Halcik/SmartPlant_Dashboard/schematy_blokowe.pdf

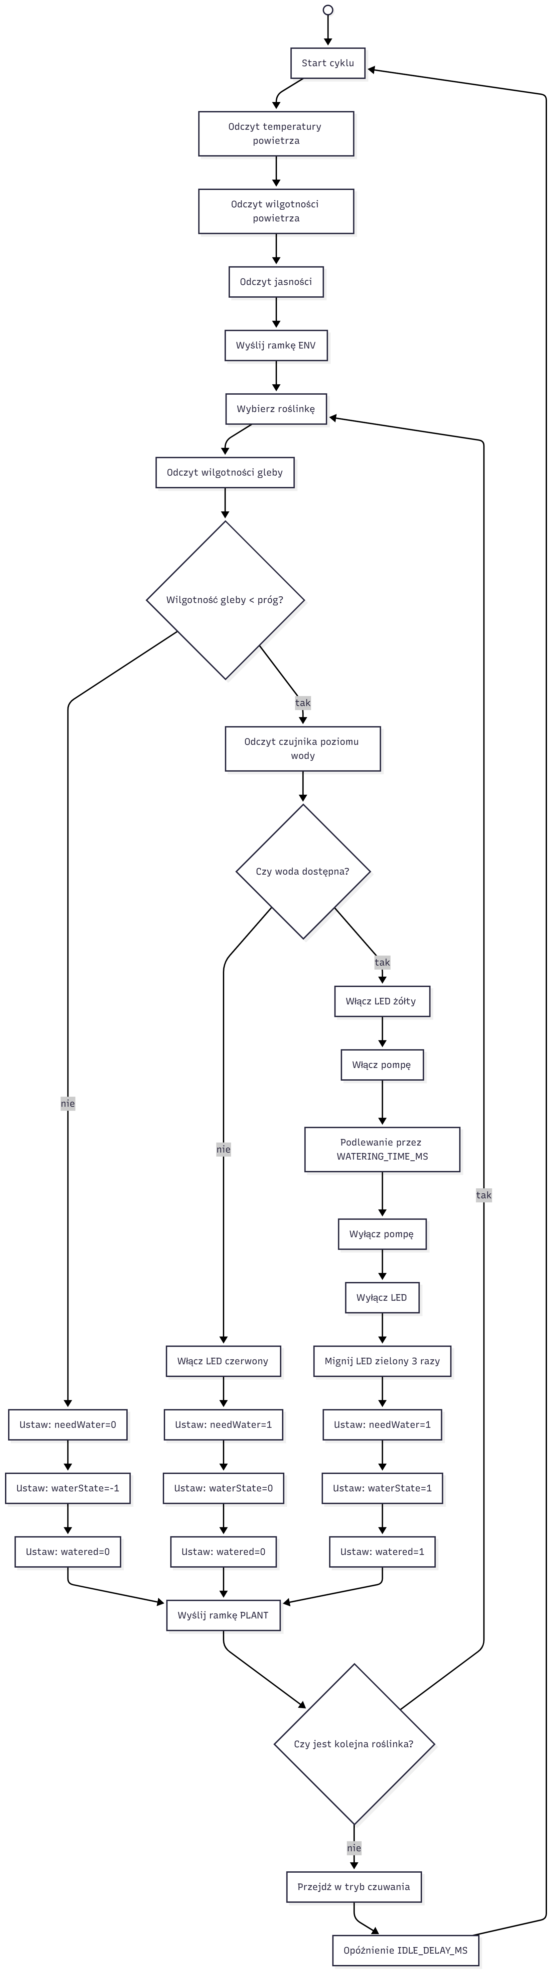
[picture p9: page 1]
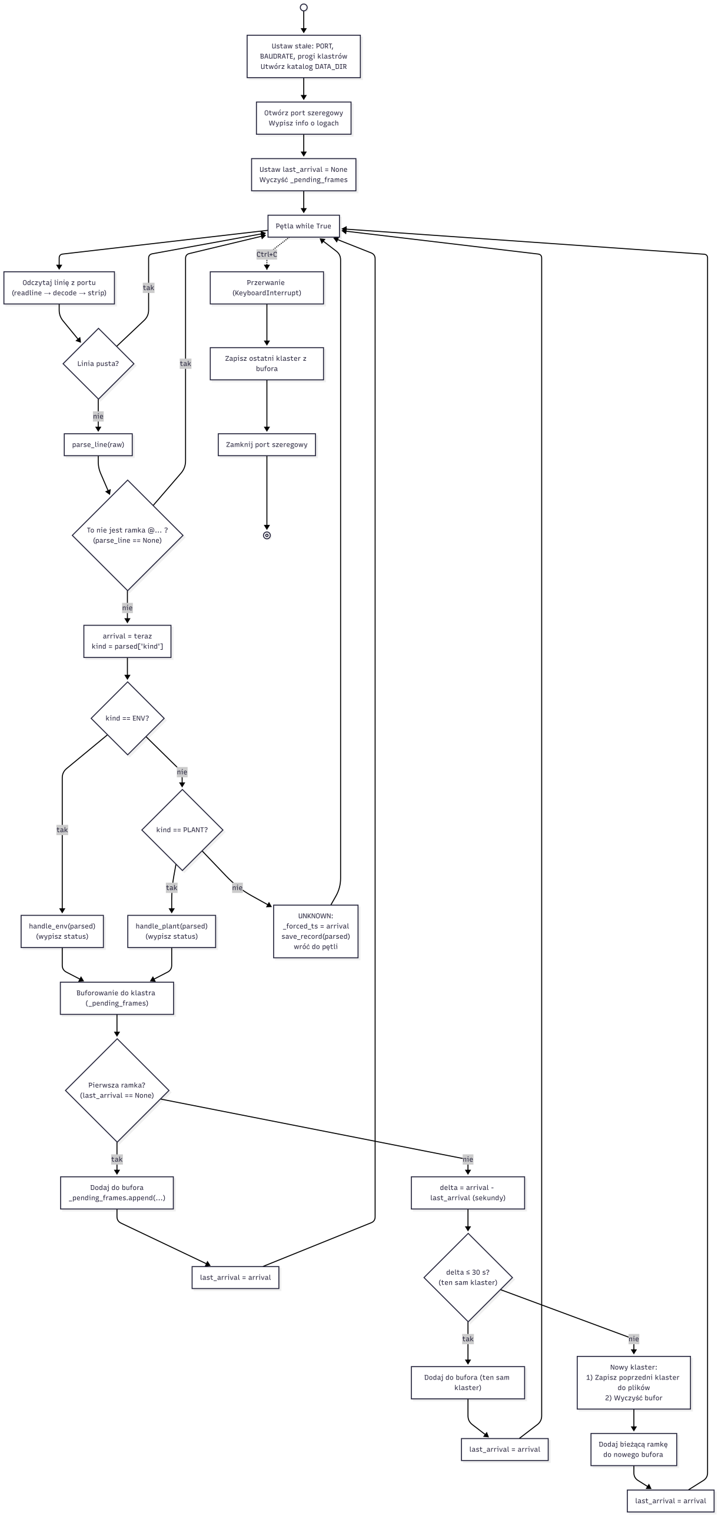
[picture p10: page 2]
